topherCantrell/pixel-OreoBoard/README.md

# Oreo Board

The Neo Pixel Oreo Board

Named after the young Golden Hurricane who inspired it.

## Hardware

Schematic:

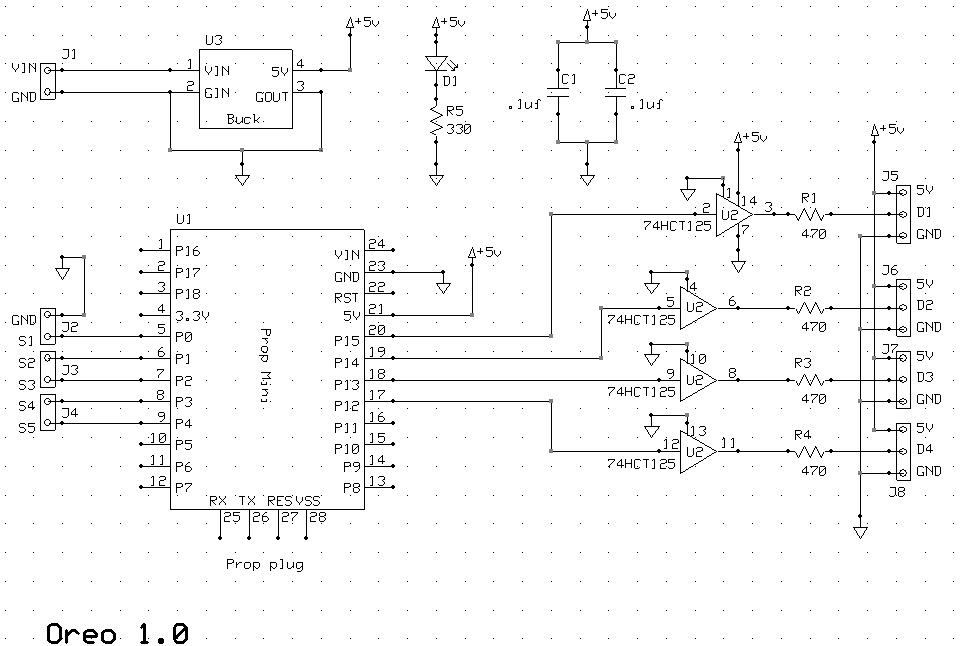
[picture p1: art/OreoSCH.jpg]


PCB:

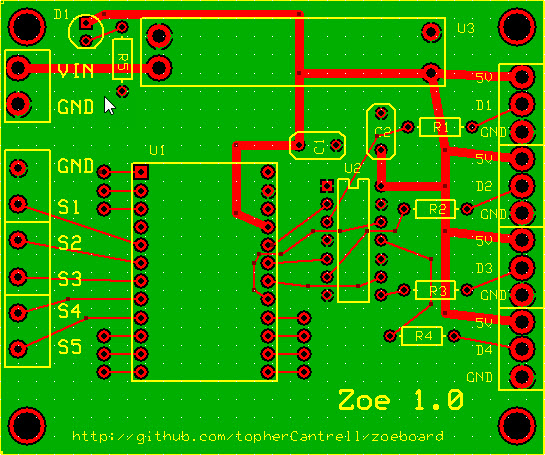
[picture p2: art/OreoPCB.jpg]


## 2016

Every year is a new robot! Here are the [specifics for the 2016 robot](https://github.com/topherCantrell/oreoboard/tree/master/2016).

# T-Shirt Cannon

TODO
