topherCantrell/pixel-OreoBoard/(list of files, drawings)

Other design files:
oreo.pcb
