topherCantrell/pixel-OreoBoard/Construction.md

# Building the Zoe Board

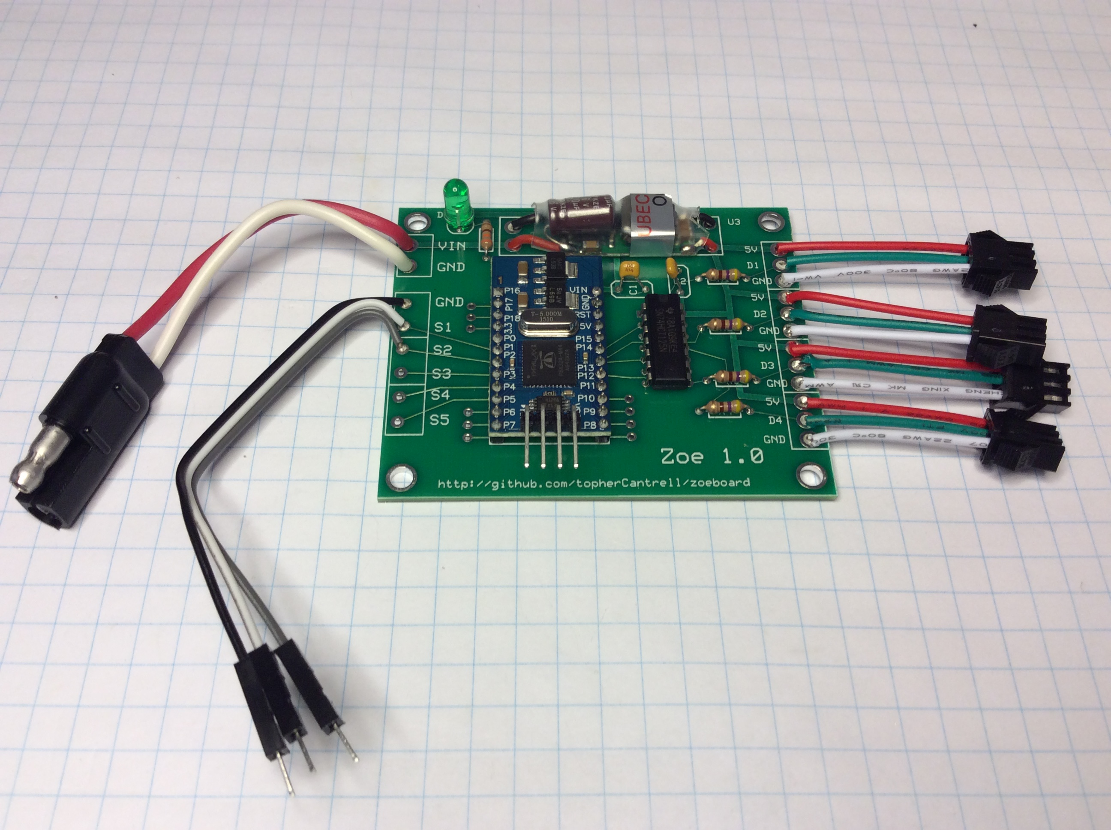
[picture p6: art/zoeBoard.jpg]


# 74HCT125 Level Shifter

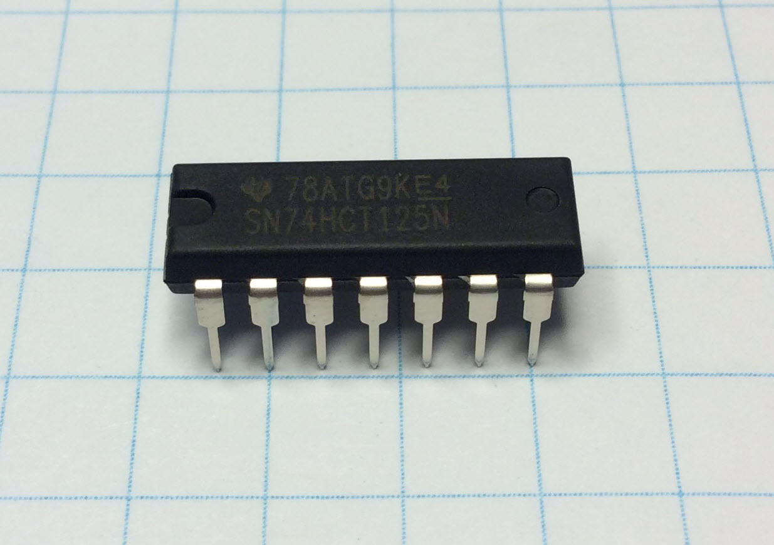
[picture p7: art/construct01.jpg]




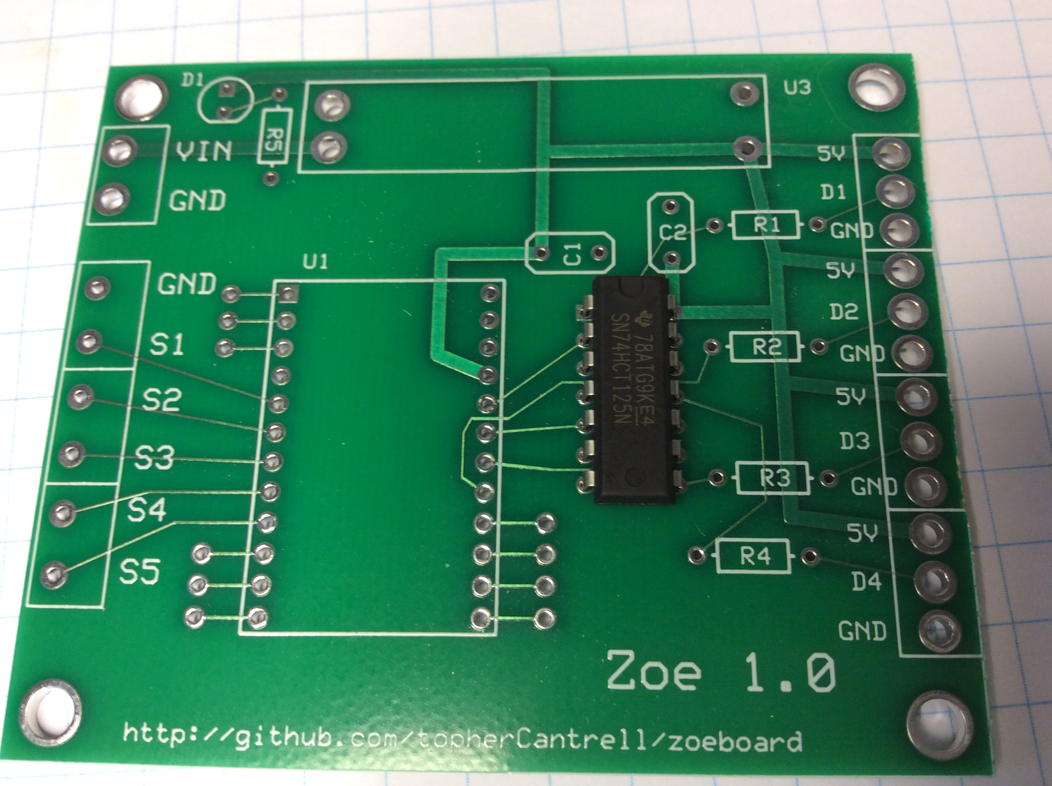
[picture p8: art/construct02.jpg]


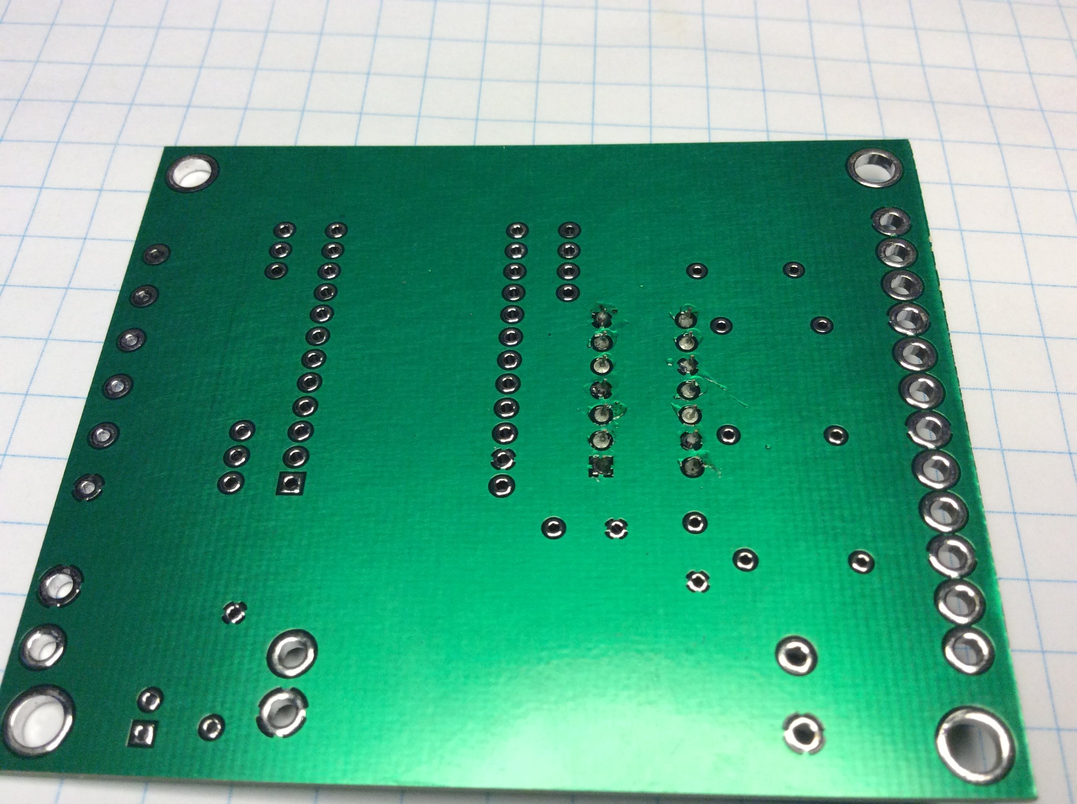
[picture p9: art/construct03.jpg]


# Propeller Mini

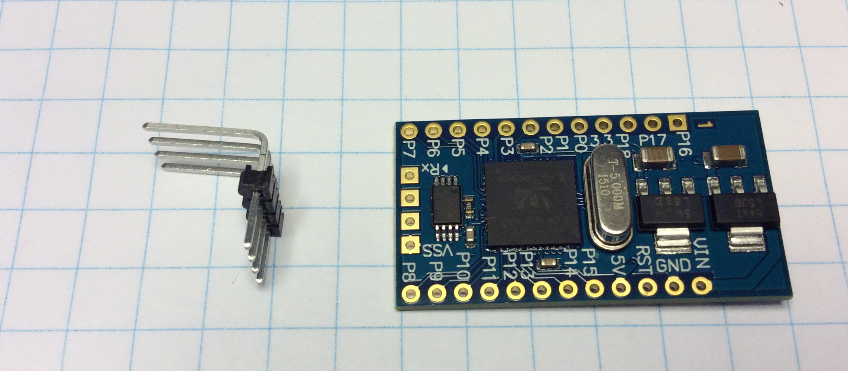
[picture p10: art/construct04.jpg]


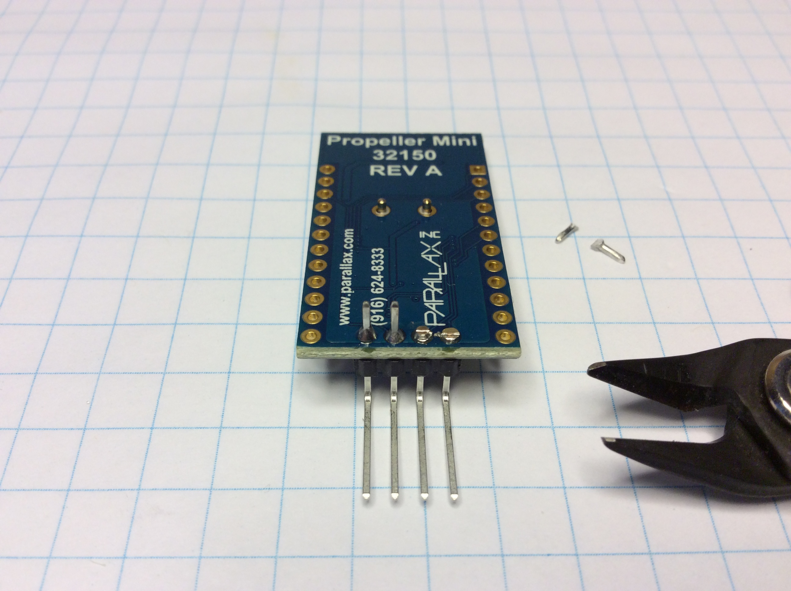
[picture p11: art/construct05.jpg]


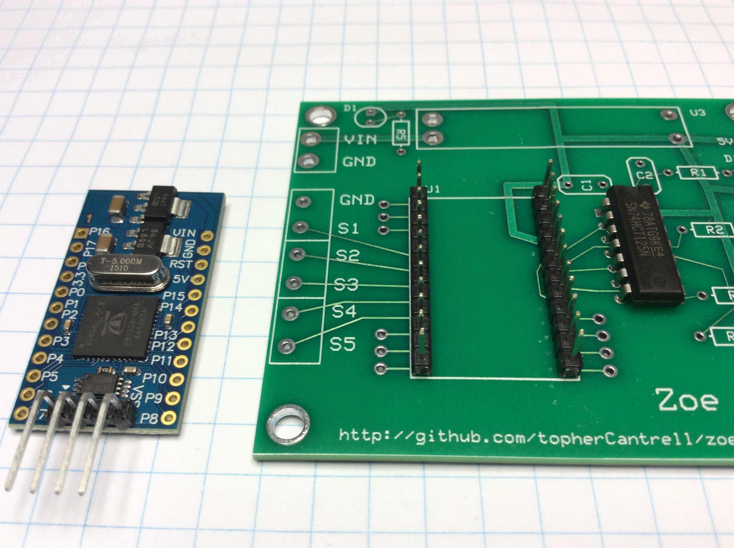
[picture p12: art/construct06.jpg]


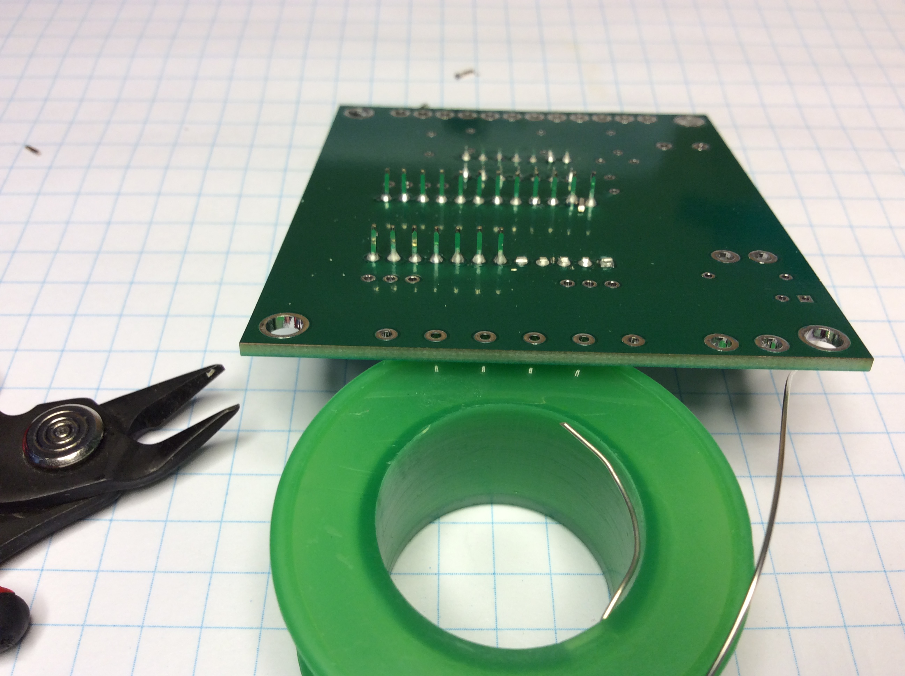
[picture p13: art/construct07.jpg]


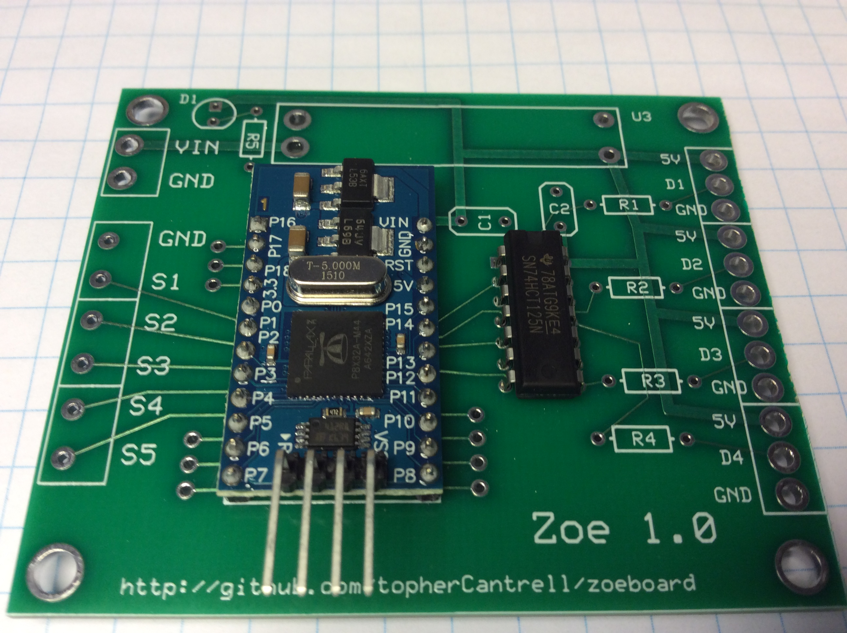
[picture p14: art/construct08.jpg]


# "Buck" DC-DC Converter

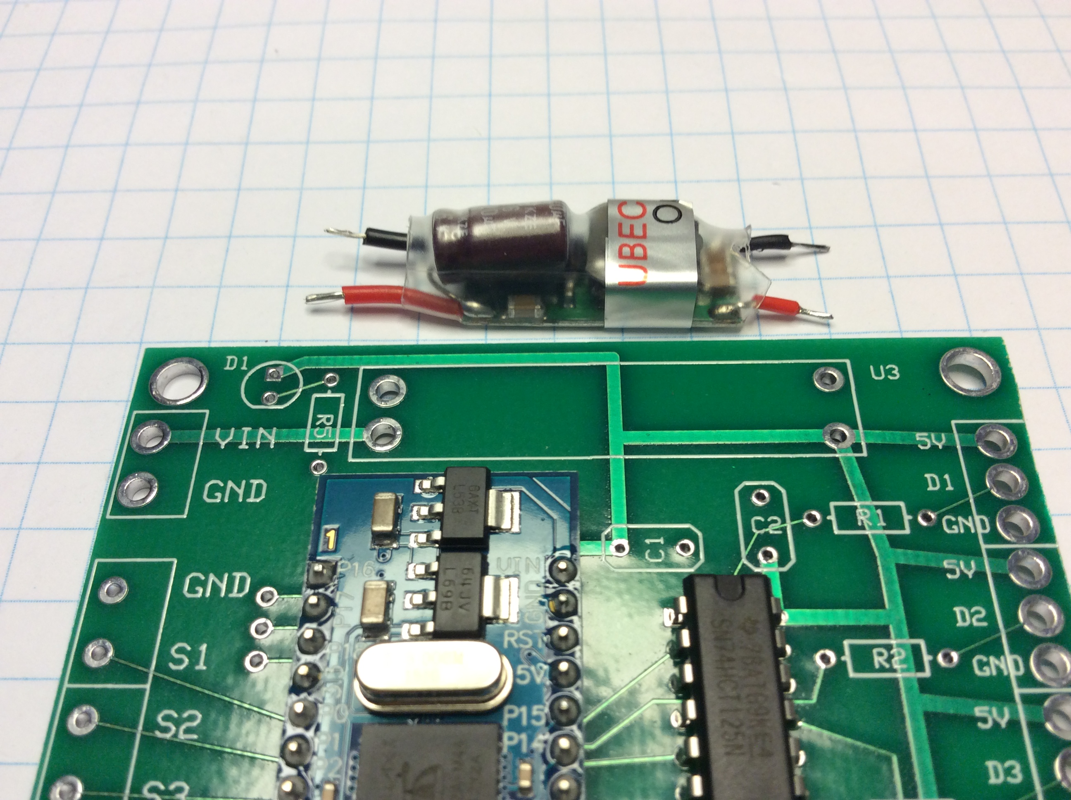
[picture p15: art/construct09.jpg]


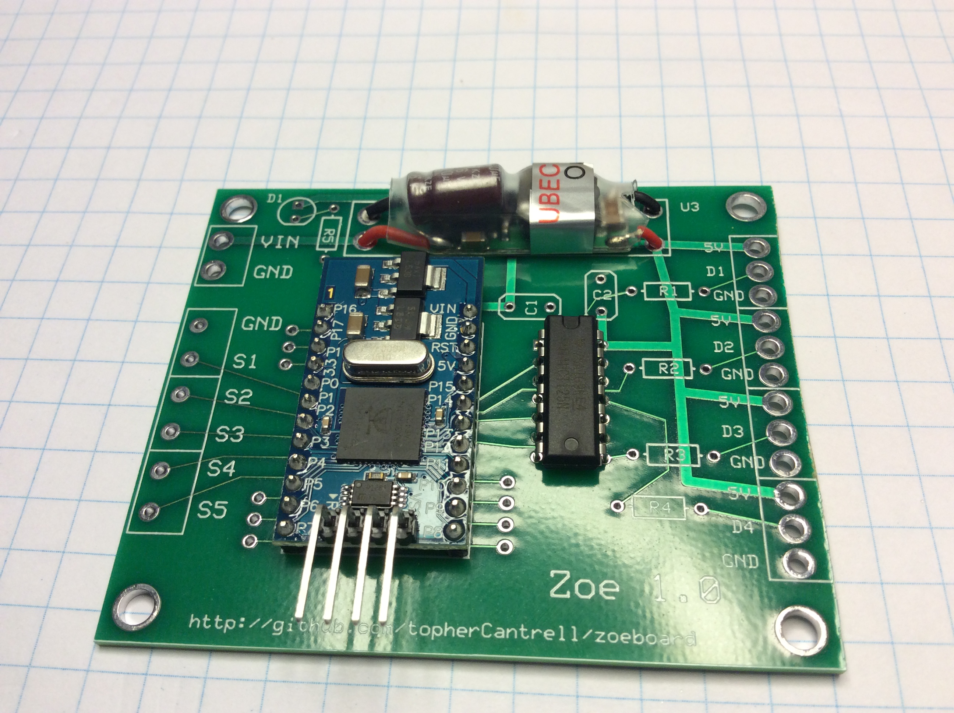
[picture p16: art/construct10.jpg]


# Resistors

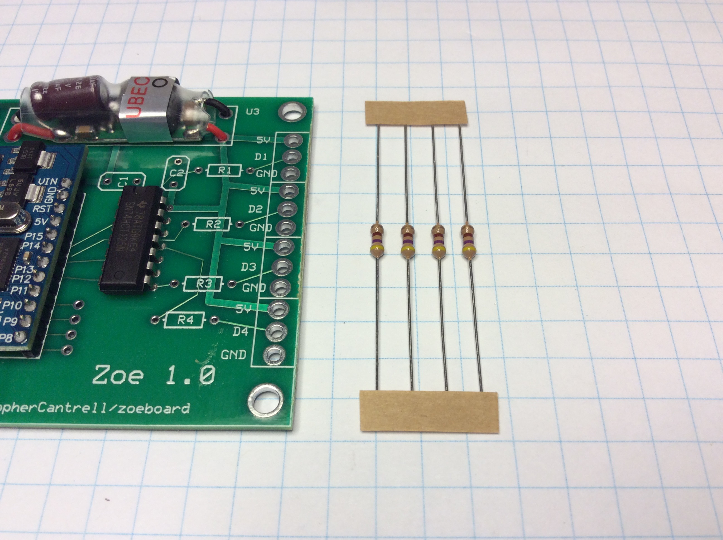
[picture p17: art/construct11.jpg]


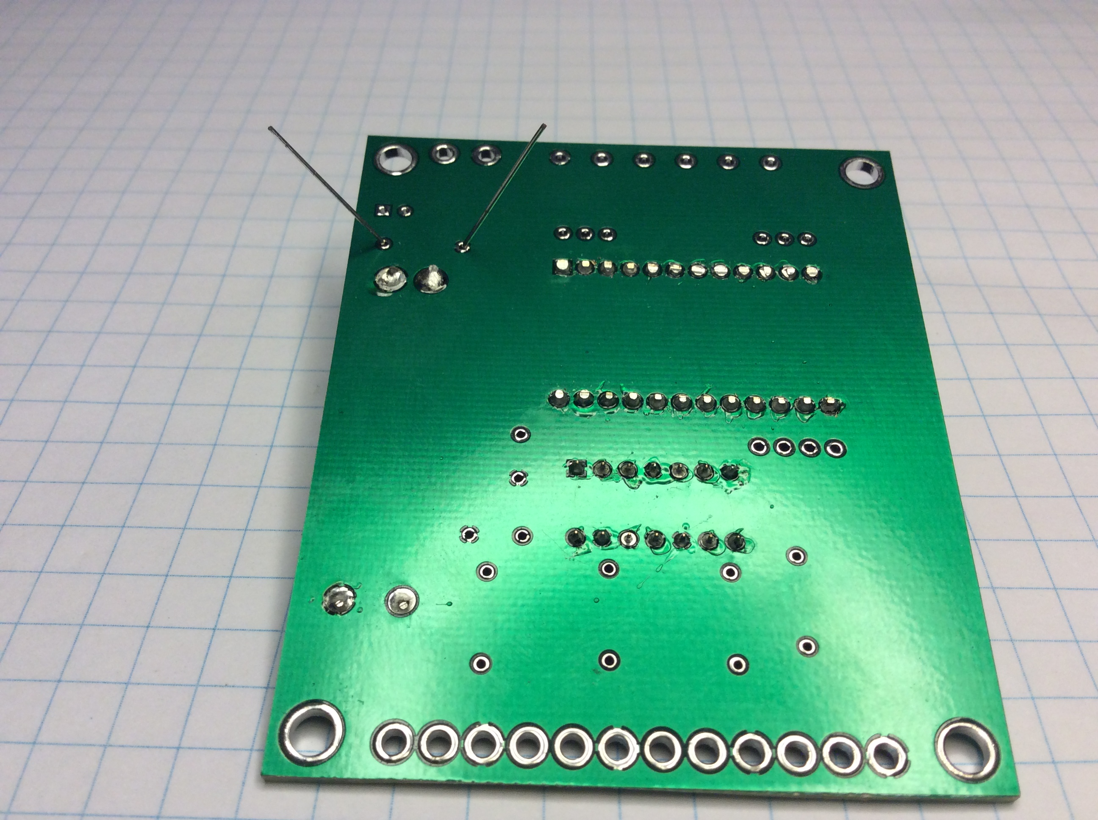
[picture p18: art/construct12.jpg]


# Capacitors

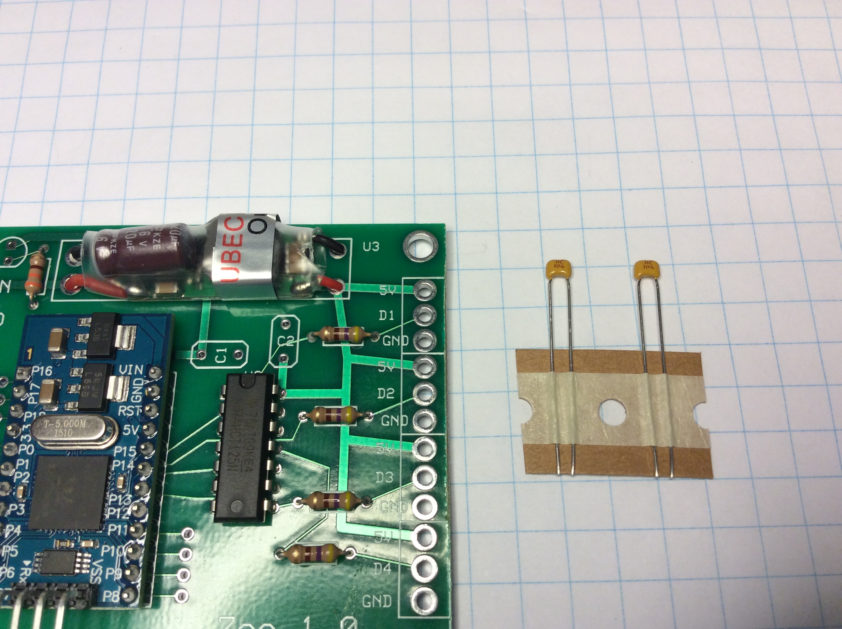
[picture p19: art/construct13.jpg]


# Power LED

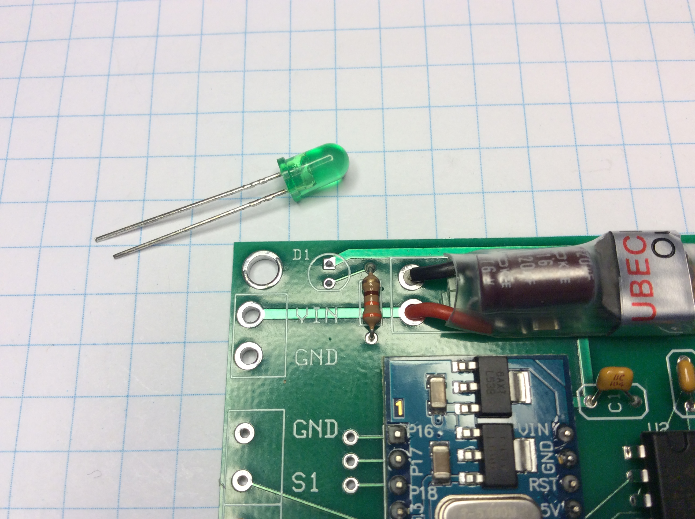
[picture p20: art/construct14.jpg]


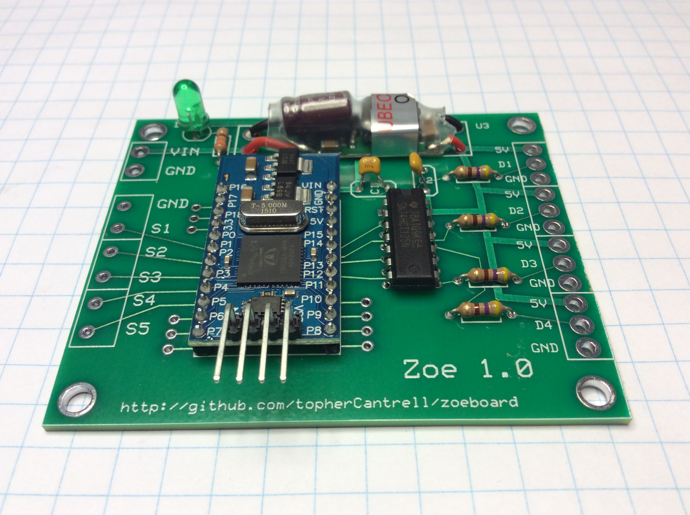
[picture p21: art/construct15.jpg]


# Connectors

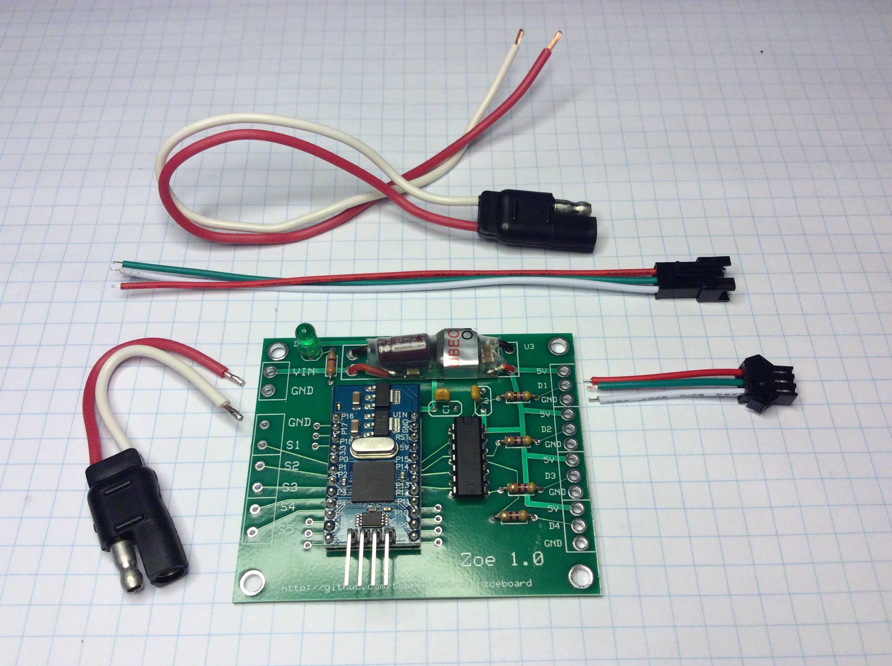
[picture p22: art/construct16.jpg]


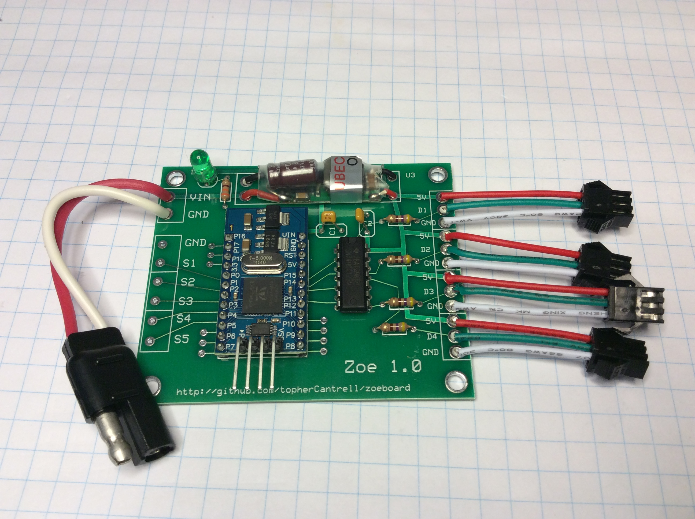
[picture p23: art/construct17.jpg]


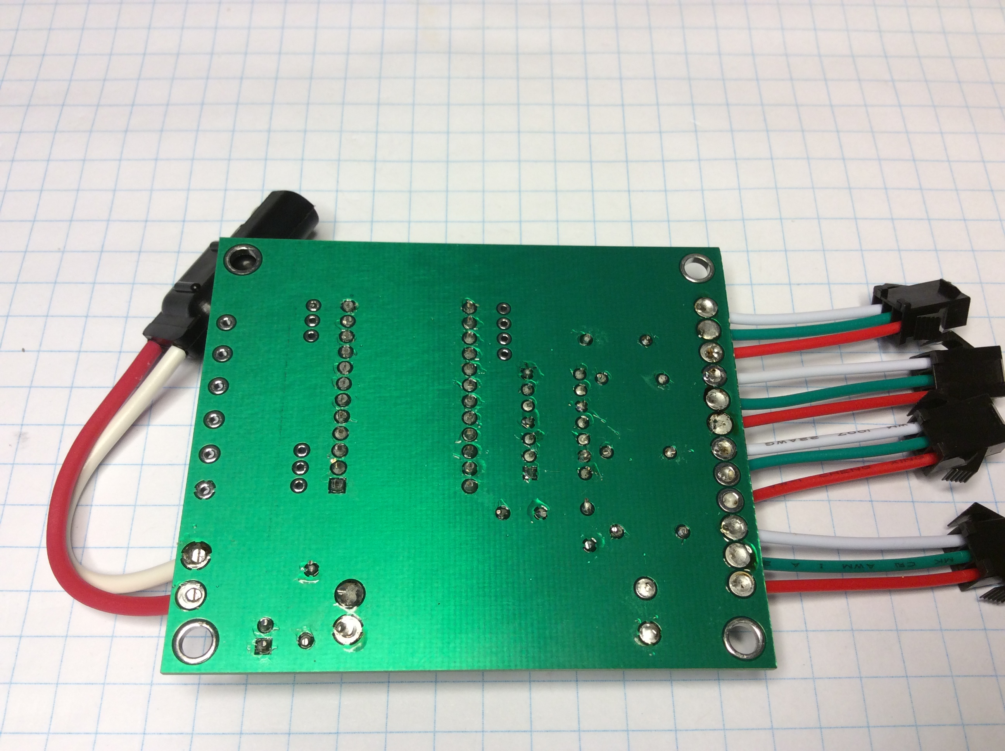
[picture p24: art/construct18.jpg]


# Serial Connector

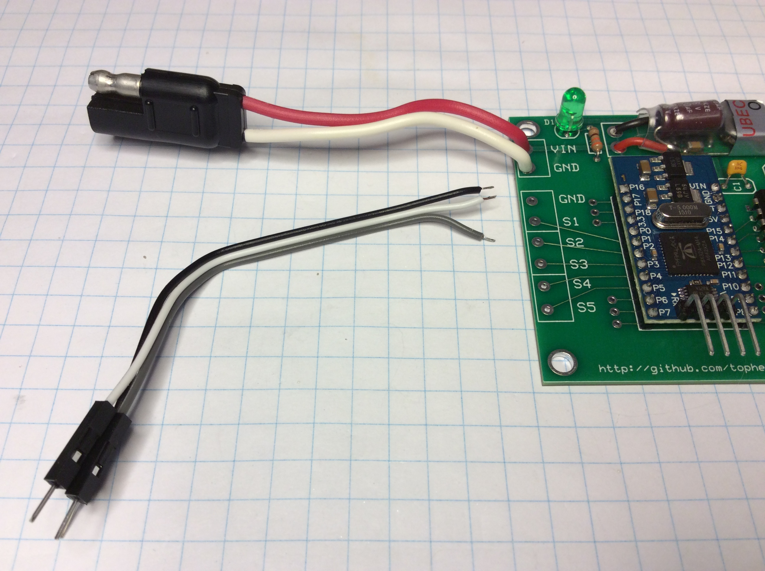
[picture p25: art/construct19.jpg]
