topherCantrell/pixel-OreoBoard/journal/README.md

# Journal

## 1/29/2017

The board works. I wired it up and ran the java serial program on it.

## 1/28/2017

I got the Oreo 1.0 boards in, and a student helped me solder the parts on. The pads for the Buck converter need to be flipped, and the holes need to be larger.

I corrected these in the PCB to version 1.1.
