topherCantrell/pixel-OreoBoard/(commit log)

2017-01-15 Initial SCH and PCB.
    [oreo.pcb, oreo.sch]
2017-01-15 PCB with wiring
    [oreo.pcb, oreo.sch]
2017-01-29 Lots of progress
    [oreo.pcb]
2017-03-16 Finished the hardware for the skid plates
2017-09-26 shared buttons
2018-01-08 Updated pads and added BOM
    [oreo.pcb]
